yangyilin52/Smart-Door-Lock/imgs/01.jpg

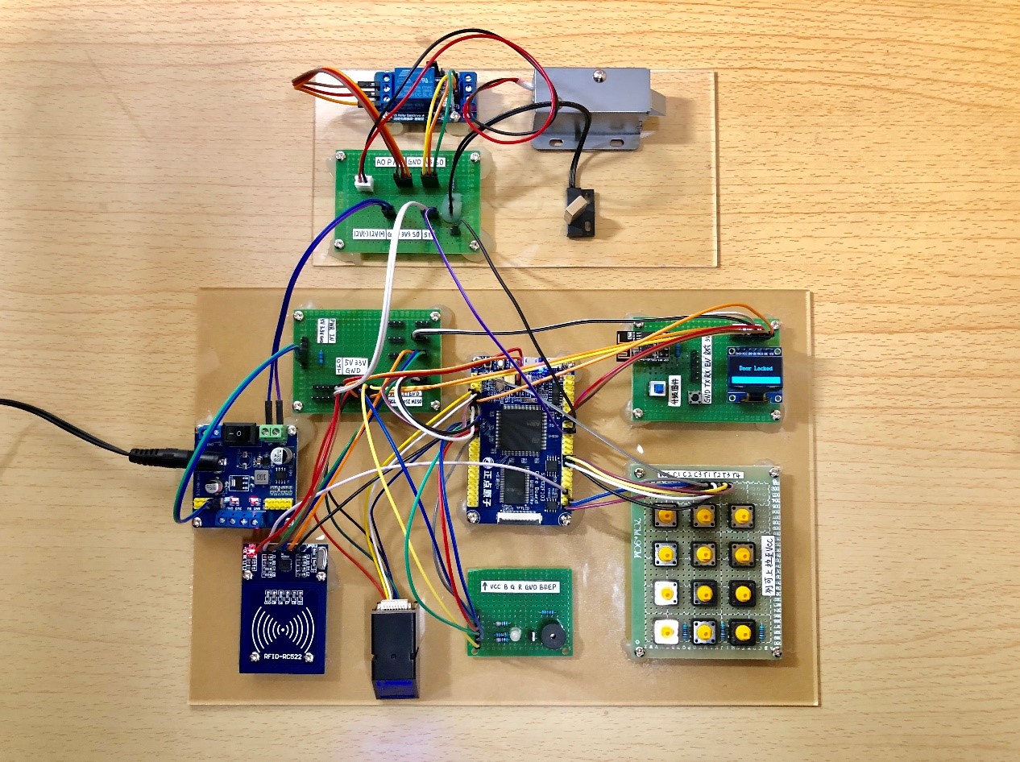
imgs/01.jpg
