yangyilin52/Smart-Door-Lock/imgs/02.jpg

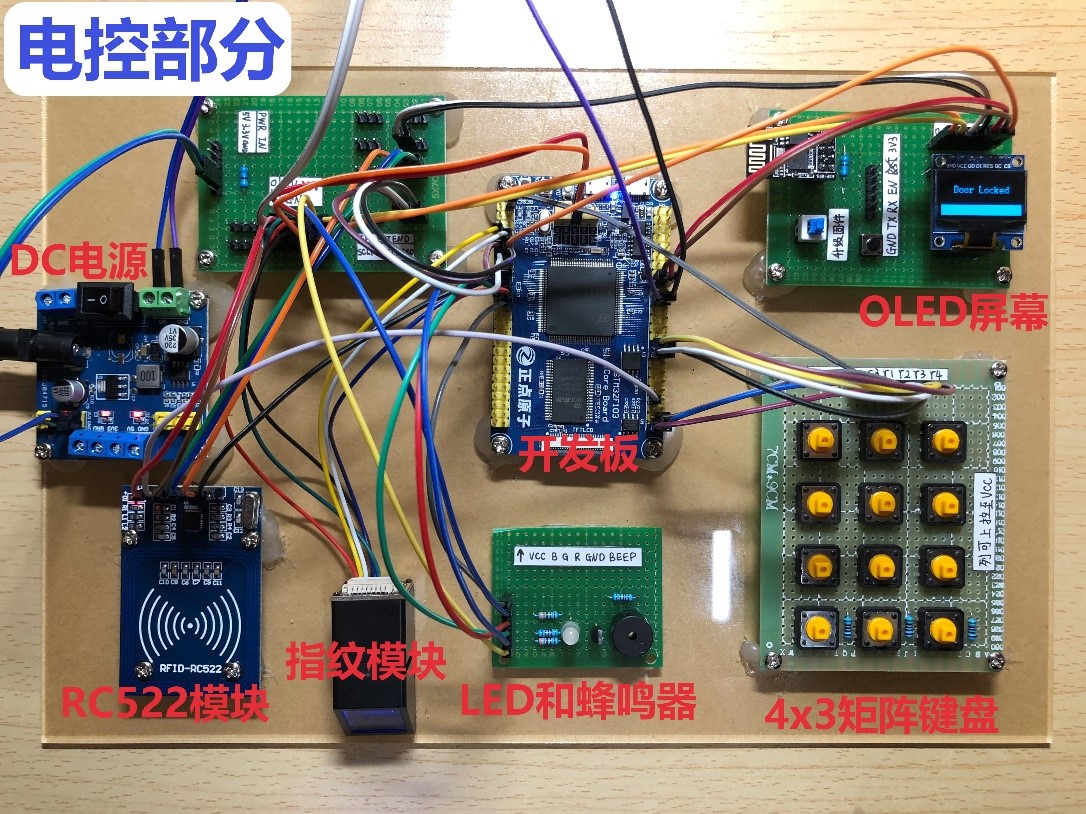
imgs/02.jpg
