yangyilin52/Smart-Door-Lock/imgs/03.jpg

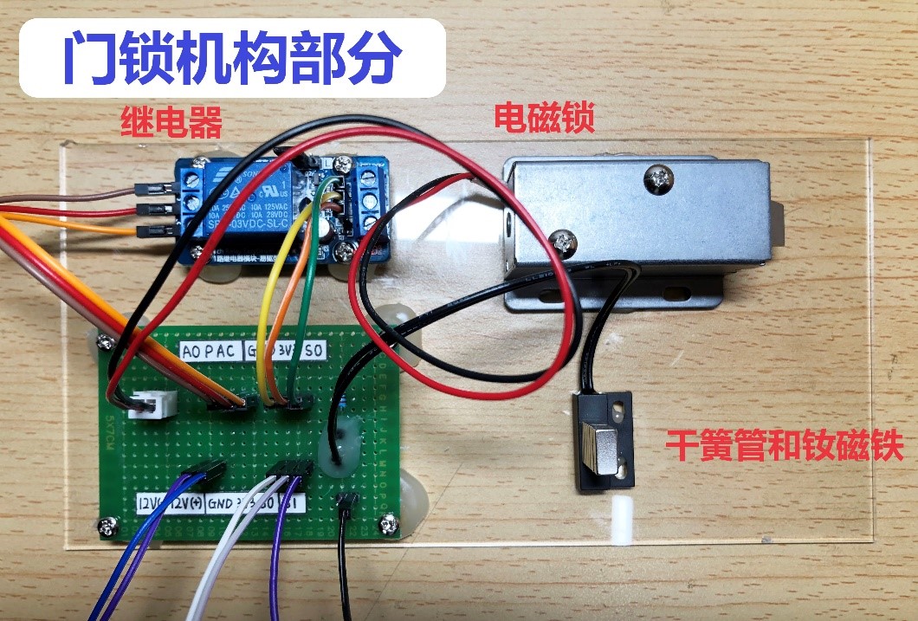
imgs/03.jpg
