yangyilin52/Smart-Door-Lock/imgs/09.png

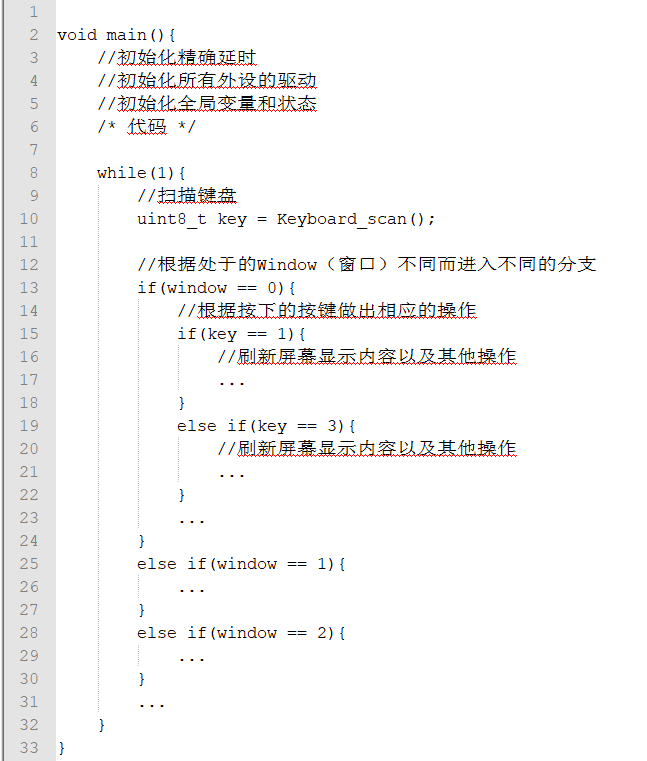
imgs/09.png
